Tanvir500/Radiation-Pattern-of-LED/EEE460G2_Group5_report.pdf

B A N G L A D E S H UN I V E R S I T Y O F E N G I N E E R I N G A N D TE C H N O L O G Y

DE P A R T M E N T O F EL E C T R I C A L A N D EL E C T R O N I C E N G I N E E R I N G

# EEE 460 (January 2024)

## Optoelectronics Laboratory

# Final Project Report

## Section: G2, Group: 05

# Radiation Pattern of LED

# Course Instructors:

Sadman Sakib Ahbab, Lecturer
Tanushri Medha Kundu, Part-Time Lecturer

Signature of Instructor: ___________________________________________________

# Academic Honesty Statement:

IMPORTANT! Please carefully read and sign the Academic Honesty Statement, below. Type the student ID and name, and put your signature. You will not receive credit for this project experiment unless this statement is signed in the presence of your lab instructor.

“In signing this statement, We hereby certify that the work on this project is our own and that we have not copied the work of any other students(past or present), and cited all relevant sources while completing this project. We understand that if we fail to honor this agreement, We will each receive a score of ZERO for this project and be subject to failure of this course.”

Signature: ____________________________
Full Name: Md. Ali Ahmed
Student ID: 1906143

Signature: ____________________________ Full Name: Manjur Muntasir
Student ID: 1906150

Signature: ____________________________ Full Name: Tanvir Rahman
Student ID: 1906176

Signature: ____________________________ Full Name: Samiul Hossain
Student ID: 1906179

i

# Table of Contents

________________________________________________________________________________________
Radiation Pattern of LED | EEE 460 (January 2024) G2, Group 05- Final Project
Front Matter ii

________________________________________________________________________________________

## 1 Abstract

LED radiation patterns change with angle, significantly affecting the intensity and overall performance, making accurate measurement crucial for various applications. To analyze these patterns effectively, a measurement setup in an enclosed environment is utilized, ensuring minimal external interference. The LEDs are positioned at fixed angles relative to a light intensity sensor to capture angular variations in radiation. Tools such as Arduino are employed for precise measurement and data analysis, enabling reliable and consistent results. The setup is designed to facilitate easy replacement of LEDs, allowing the testing of different colors such as red and green, making it versatile for various experiments. This streamlined and repeatable measurement process supports the optimization of lighting designs to achieve improved efficiency and enhances optical communication systems for superior performance.

## 2 Introduction

An LED is a semiconductor device that produces light when an electric current flows through it. It emits light directionally, with the highest intensity radiating perpendicularly to its surface. The majority of the emitted energy is concentrated within a 20° angle around this peak direction. Measuring the radiation pattern of LEDs is crucial for evaluating their optical properties. This pattern reveals how light is distributed in various directions, offering essential insights for optimizing LED designs in applications such as lighting, displays and optical communication systems.
Accurate measurement of an LED’s radiation pattern requires a carefully designed experimental setup. Such a setup ensures precise, consistent data collection and involves a range of well-selected components and instruments that map the spatial light distribution effectively. In this project, we detail the experimental arrangement used to measure LED radiation patterns, including components like light sources, detectors, microcontrollers and power supplies. By maintaining controlled environmental conditions and calibrating the equipment, we can generate reliable data to analyze LED performance under various operating scenarios.
This study highlights the role and significance of each component in the experimental setup, emphasizing their contributions to measurement accuracy. The project's ultimate aim is to thoroughly investigate the radiation patterns of LEDs of different types, colors and sizes across varying angles, providing a comprehensive understanding of their optical behavior.

## 3 Design

### 3.1 Problem Formulation

### 3.1.1 Identification of Scope

Application of Engineering Principles: This project applies core engineering concepts by using sensors and Arduino-based setups to measure LED radiation patterns. The process includes capturing light intensity data at various angles and analyzing it to understand LED behavior, demonstrating the integration of hardware and software in solving measurement challenges.

Problem Analysis: A key aspect of this study is understanding and quantifying how LED light intensity varies with angular positioning. By analyzing these variations, the project identifies patterns and relationships that influence LED performance.

Practical Skills Development: The project provides hands-on experience in designing, implementing, and optimizing experimental setups. Participants gain practical skills in configuring sensors, programming Arduino boards, calibrating equipment, and troubleshooting, which are valuable for real-world applications.

Contribution to Real-World Applications: Insights from LED radiation patterns can improve optical communication systems by optimizing light emission properties and aid in designing energy-efficient lighting solutions for applications ranging from residential to industrial settings.

### 3.1.2 Literature Review

Alessandro et al. (2023) explored the use of UV LEDs for curing UV protective coatings on the inner surfaces of pipes in the oil and gas industry. The optimal lamp design was determined by simulating and evaluating radiation patterns based on LED arrangement and spacing to minimize intensity variation on the pipe surface. The constructed lamp's irradiance was experimentally validated using a radiometer.

Moreno et al. (2022) measured the pattern using Gaussian or cosine-power function which is applicable for diverse LED types.

### 3.1.3 Formulation of Problem

The formulation of the problem for this project focuses on accurately measuring the radiation pattern of LEDs to optimize their application in lighting environments. The primary challenges involve ensuring precise light intensity measurement across different angles and eliminating external interference from ambient light. The goal is to develop a reliable setup that produces valuable insights for designing effective LED lighting systems.

### 3.1.4 Analysis

The goal is accurately measuring the radiation pattern of LEDs by addressing key challenges such as ensuring precise light intensity measurement across different angles and eliminating external interference from ambient light. The objective is to develop a reliable, simple and robust setup that provides valuable insights for optimizing LED lighting systems.

### 3.2 Design Method

Design Method for Measuring LED Radiation Pattern:

### 1. Setup Overview:

The experimental design focuses on precisely measuring the radiation pattern of an LED by determining the relationship between the angle and light intensity. The setup consists of a stationary LED and a rotating BH1750 light intensity sensor, controlled by a stepper motor. An Arduino Nano microcontroller coordinates the operation, while MATLAB is used for data analysis and visualization. The whole setup is put in a box that covers it from all sides ensuring no light gets into it while testing.

### 2. Hardware Components:

LED: The light-emitting diode under test is fixed in a stable position to ensure accurate measurement without displacement.
BH1750 Light Intensity Sensor: A digital light sensor with high precision, used to record the intensity of light at different angles.
Stepper Motor: Provides precise angular movement, allowing the sensor to rotate around the LED in controlled increments over a range of 180 degrees.
Arduino Nano: Acts as the central controller, managing the stepper motor's movement and collecting intensity data from the BH1750 sensor.
Power Supply: Provides necessary power to the LED, Arduino and stepper motor.

### 3. Procedure:

Step 1: Initial Setup: Mount the LED and BH1750 light sensor securely on the setup. The LED is positioned at the center, while the sensor is fixed on a rotating arm connected to the stepper motor.
Step 2: System Calibration: Calibrate the BH1750 sensor to ensure accurate intensity measurements. Verify the stepper motor’s angular movement to confirm it aligns with the desired resolution (e.g., 1.8° per step).
Step 3: Data Acquisition: The Arduino Nano initiates the stepper motor, rotating the sensor around the LED in predefined increments. At each step, the BH1750 measures the light intensity and sends the data, along with the current angle, to the Arduino.
This process continues until the sensor completes the 180-degree sweep.
Step 4: Data Transmission: After completing the measurements, the Arduino sends the collected angle-intensity data to a connected computer via serial communication.

### 4. Data Analysis and Visualization:

The data is imported into MATLAB, where it is processed and plotted.
Using MATLAB's plotting functions, the radiation pattern is visualized as a polar plot or Cartesian graph, providing a clear representation of light intensity distribution at various angles.

### 5. Advantages of the Design:

Precision: The stepper motor ensures accurate angular positioning of the sensor. Automation: The Arduino Nano automates data collection, minimizing human error. Flexibility: The setup can be adapted to test LEDs of different sizes, colors or power ratings.

### 3.3 Circuit Diagram

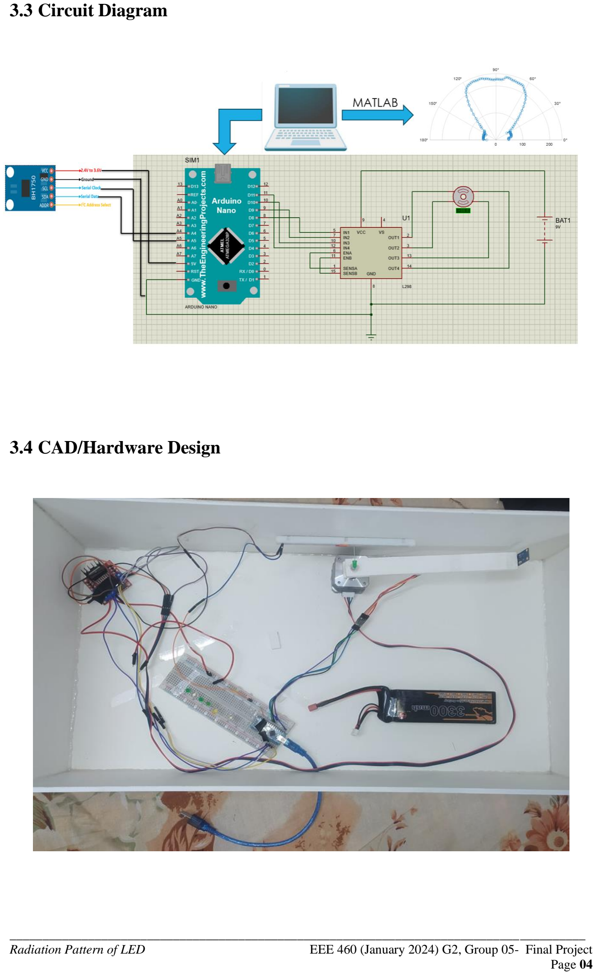
[picture p1: page 7]

### 3.4 CAD/Hardware Design

### 3.5 Full Source Code of Firmware

Arduino Code:

#include <Stepper.h> | clc;

#include <BH1750.h> | close all;

#include <Wire.h> | clear;

// Stepper Motor Settings | % MATLAB script to read serial data from Arduino and
const int stepsPerRevolution = 100; // Number of steps | plot lux vs angle
per revolution for your motor
const float stepAngle = 180.0 / stepsPerRevolution; // | % Parameters
Degrees per step | serialPort = 'COM4'; % Replace with your Arduino's
Stepper myStepper(stepsPerRevolution, 8, 9, 10, 11); // | serial port
Motor pins | baudRate = 9600;

// Light Sensor Settings
BH1750 lightMeter;
// Measurement Settings | configureTerminator(arduino, 'LF'); % Ensure the data
const int numMeasurements = 50; // Number of light | is newline-terminated
readings per step | flush(arduino); % Clear any old data in the buffer
const int stepDelayMs = 510; | // Delay after each
step (ms) | % Wait for Arduino to send "READY"
const int measureDelayMs = 10; // Delay between light | disp('Waiting for Arduino to initialize...');
readings (ms) | while true
// Variables | disp(line); % Display for debugging
float currentAngle = 0.0; | if contains(line, "READY")
void setup() { | break;
// Initialize Serial communication | end
Serial.begin(9600); | end
Serial.println("Arduino Light Measurement and Motor
Control");
// Initialize I2C and BH1750 | writeline(arduino, "RUN");
Wire.begin(); | disp('RUN command sent to Arduino.');
if (!lightMeter.begin()) {
Serial.println("Error initializing BH1750 sensor"); | % Initialize data arrays
while (1); // Halt execution if sensor | angles = [];
initialization fails | luxValues = [];
}
Serial.println("BH1750 sensor initialized");
// Initialize Stepper motor | while numel(angles) < expectedSteps
myStepper.setSpeed(5); // Set motor speed (RPM) | line = readline(arduino); % Read a line of

// Notify MATLAB that Arduino is ready
Serial.println("READY");
// Wait for "RUN" command from MATLAB | if contains(line, "Step") || contains(line,
while (true) { | "Measurement complete")
if (Serial.available()) { | continue;
String command = Serial.readStringUntil('\n'); | end
command.trim();
if (command == "RUN") { | % Parse the CSV data (Step, Angle, Lux)
Serial.println("RUN RECEIVED"); | data = split(line, ',');
break; // Exit loop and proceed | if numel(data) == 3
} | angle = str2double(data{2}); % Convert
} | angle to numeric
delay(100); // Avoid busy-waiting | lux = str2double(data{3}); % Convert lux
} | to numeric
}
void loop() { | degrees
for (int stepCount = 0; stepCount < | if angle <= 180
stepsPerRevolution; ++stepCount) { | angles(end+1) = angle; %#ok<SAGROW>
// Move one step | luxValues(end+1) = lux; %#ok<SAGROW>
myStepper.step(-1); | end
currentAngle += stepAngle; | end

delay(stepDelayMs); // Wait for motor to stabilize

// Take multiple light readings and calculate | interruption)
average | disp('Stopped reading data from Arduino.');
float lightSum = 0.0; | end
for (int i = 0; i < numMeasurements; ++i) {
lightSum += lightMeter.readLightLevel(); | % Close the serial port
delay(measureDelayMs); | clear arduino;
}

Matlab Code:

expectedSteps = 100; % Total number of steps expected

% Open the serial port
arduino = serialport(serialPort, baudRate);

line = readline(arduino);

disp('Arduino is ready.');

% Send the "RUN" command to start the motor and measurements

% Read data from serial port try

data
disp(line); % Display the line for debugging

% Skip lines that don't contain valid data

% Append to arrays if angle is within 0–180

end
catch
% Stop reading when an error occurs (e.g., user

Table: Source Code for the main program

## 4 Implementation

### 4.1 Description

### Implementation of LED Radiation Pattern Measurement Design

### 1. Hardware Assembly

a. Components Required:
- LED: Secure the LED on a stable base to ensure it remains fixed during the experiment.
- BH1750 Light Sensor: Mount this sensor on a rotating arm attached to the stepper motor.
- Stepper Motor: Use a bipolar stepper motor for precise angular movement of sensor.
- Arduino Nano: Act as the controller for the system.
- Motor Driver Module: Such as ULN2003 (for unipolar motors) or A4988 (for bipolar motors), to interface the stepper motor with the Arduino.
- Power Supply: Provide stable power for the motor, Arduino, and LED.
- Connecting Wires: For wiring components to the Arduino.
- Breadboard or PCB: For organizing connections.
b. Assembly Steps:
1. Fix the LED in the center of a circular base.
2. Attach the BH1750 sensor to an arm extending from the stepper motor's shaft. Ensure the arm is long enough to position the sensor at a suitable distance from the LED.
3. Connect the stepper motor to the Arduino Nano via the motor driver module.
4. Wire the BH1750 sensor to the Arduino Nano using I2C communication (SCL and SDA pins).
5. Connect the power supply to all components.

### 2. Arduino Programming (Code above)

float lightAverage = lightSum / numMeasurements;

// Send data to Serial
Serial.print(stepCount + 1); // Step number | % Plot the data in a radial plot
Serial.print(", "); | figure;
Serial.print(currentAngle, 2); // Angle in degrees | polarplot(anglesRad, luxValues, '-o');
Serial.print(", "); | title('Light Intensity vs Angle (0–180 degrees)');
Serial.println(lightAverage, 2); // Average light | ax = gca;
in lx | ax.ThetaLim = [0 180]; % Limit the angle to 0–180
} | degrees
// Return to the initial position | ax.RGrid = 'on';
myStepper.step(stepsPerRevolution); | ax.ThetaTick = 0:30:180; % Set angular ticks
Serial.println("Measurement complete.");
while (true) {
delay(1000); // Halt execution
}
}

% Convert angles to radians for polar plotting anglesRad = deg2rad(angles);

ax.RLim = [0 max(luxValues)+10];

### 3. Data Collection

1. Upload the code to the Arduino Nano.
2. Open the Arduino IDE Serial Monitor to view angle vs. light intensity data in real-time.
3. Copy the data into a text file or spreadsheet for further processing.

### 4. Data Analysis in MATLAB

Testing and Calibration:

- Test the setup by rotating the sensor manually to confirm alignment with the LED.
- Calibrate the BH1750 sensor in standard lighting conditions to ensure right measurements.

Expected Output:

- A polar plot in MATLAB showing the distribution of light intensity as a function of angle.
- Additional data insights can be extracted by analyzing intensity variations across the angular sweep.

### Challenges to Implementation:

1) Increasing cost if we use multiple sensor.
2) Ensuring no light from environment.
3) Stepper motor coil issues.
4) Motor driver excessive heating problem due to high current draw.
5) Get real time data analysis.
6) Defects in jumper wires.
7) Sending data to MATLAB while plotting.

## 5 Design Analysis and Evaluation

### 5.1 Novelty

Automation of Measurement:

This project introduces an automated approach to measuring LED radiation patterns, utilizing an Arduino microcontroller to streamline the process. Traditionally, such measurements have been conducted manually in the BUET Optoelectronic Lab, a method that is both time-consuming and prone to human error. By automating the system, we significantly enhance time efficiency and ensure consistent and accurate data collection. The automated setup involves precise motorized control of sensor movements, synchronized with real-time data acquisition. This eliminates the need for manual adjustments and readings, allowing for faster measurements and more reliable results. Moreover, the integration of automation reduces variability in experimental conditions, thereby improving the repeatability of measurements and the overall quality of the data.

Customized Radiation Pattern Analysis:

The developed system is not only efficient but also versatile, enabling detailed analysis of LED radiation patterns tailored to diverse applications. By leveraging the precision and flexibility of the automated setup, the system can characterize LEDs for specific use cases such as agriculture, lighting design and automotive applications. For instance:

Agriculture: Understanding the radiation pattern of LEDs used in grow lights helps optimize light distribution, ensuring plants receive uniform illumination for better growth.

Lighting Design: Analyzing radiation patterns aids in designing energy-efficient and aesthetically pleasing lighting systems for residential, commercial or industrial use.

Automotive: Detailed radiation pattern measurements help in designing headlights and interior lights that enhance visibility and safety.

This tailored approach allows for the selection and modification of LEDs to meet specific requirements, ensuring that lighting solutions are efficient, cost-effective and optimized for their intended purpose. Through automation and customization, the project not only advances experimental methodology but also contributes to practical, real-world lighting innovations.

### 5.2 Design Considerations

### 5.2.1 Considerations to public health and safety

This project focuses on considerations for public health and safety related to LED radiation patterns and measurement setups. The study emphasizes the need for a controlled environment to minimize external interference and ensure accurate intensity measurements. It addresses potential risks by carefully positioning LEDs and utilizing tools like Arduino for precise data collection. The project aims to optimize lighting designs and enhance optical communication systems, all while ensuring the safety and well-being of individuals through rigorous adherence to safe measurement practices.

### 5.2.2 Considerations to environment

The project considers environmental impacts related to LED radiation patterns and measurement setups. It involves minimizing external interference by using an enclosed environment, which reduces the potential for interference from the surroundings. The design also takes into account the energy efficiency of lighting systems and optical communication technologies, aiming to reduce their environmental footprint. By employing tools like Arduino for precise measurements, the project promotes sustainable practices, ensuring that the setup and outcomes are environmentally friendly and contribute positively to the surrounding ecosystem.

### 5.2.3 Considerations to cultural and societal needs

The project considers cultural and societal needs by addressing the impact of LED radiation patterns on lighting designs and optical communication systems. It ensures that the measurement setup is adaptable to different societal preferences for light quality and color. The project also takes into account cultural considerations such as lighting aesthetics and energy consumption, aiming to align technological advancements with societal values. By providing a streamlined and flexible measurement process, the project supports the development of lighting solutions that meet diverse cultural requirements, enhancing user experience and contributing positively to societal needs.

### 5.3 Investigations

### 5.3.1 Results and Analysis

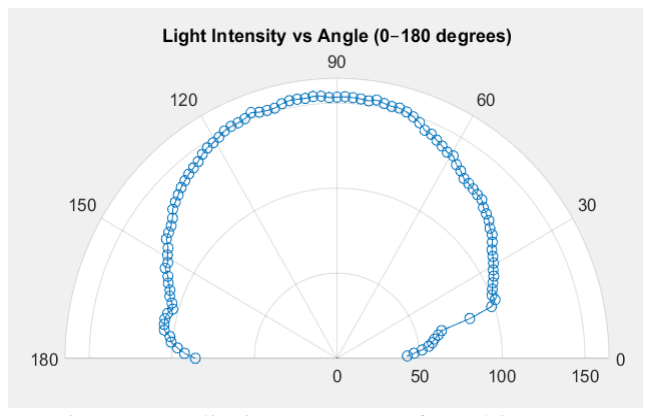
[picture p2: figure]

Figure: Radiation pattern of a white LED

This particular LED had a hemispherical enclosure and consequently, the shape of the radiation pattern matches the shape for a hemispherical LED in literature.

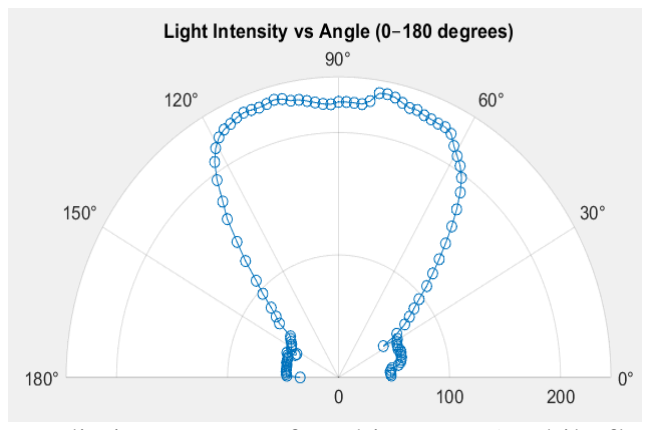
[picture p3: figure]

Figure: Radiation pattern of a white LED (mobile flashlight)

A phone’s flashlight needs to cover a greater angle than typical directional LEDs. This can be seen from its radiation pattern.

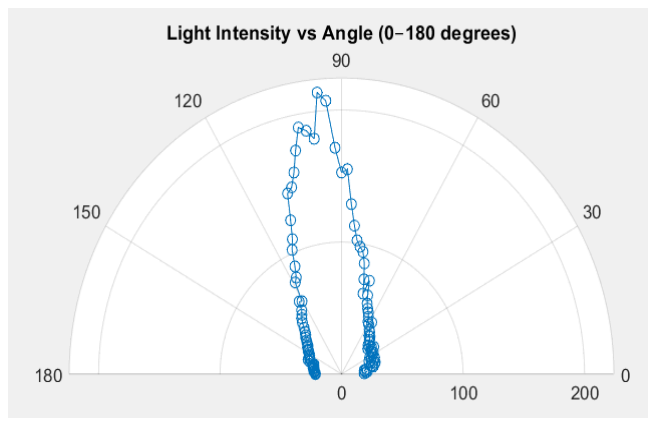
[picture p4: figure]

Figure: Radiation pattern of a green LED.

The casing of this particular LED was parabolic. Hence, we see this highly directional pattern. Our ideal sensor distance was measured for this particular LED and was then fixed.

### 5.3.2 Interpretation and Conclusions on Data

It is clear that our setup can measure radiation patterns of LEDs of differing colors and casing shapes. For the measurements that we carried out, the reflections of light within our box do not interfere with the data to the extent that the radiation pattern shape is inaccurate for various shapes. Moreover, the setup of our sensor to led distance seems optimum. For the mechanical jittering of the motor, we think our averaging scheme works well to smooth out any deviations in the measurements due to sudden movements of the arm.

### 5.4 Limitations of Tools

The proposed system for measuring LED radiation patterns, while innovative and effective, has limitations in the tools and components used. The BH1750 light sensor, though convenient, has a broad field of view, reducing precision for narrow beam patterns and limiting multi-spectral analysis due to its inability to differentiate wavelengths. Additionally, it may saturate under high-intensity LEDs without the use of optical filters. The stepper motor, responsible for sensor rotation, has constraints such as limited angular resolution, potential vibration, and a trade-off between speed and precision. Arduino Nano, as the controller, introduces limitations with its low processing power, limited memory and insufficient I/O pins for more complex setups. It also lacks onboard storage and wireless communication capabilities, which could hinder real-time data transfer. Serial communication for data transfer to MATLAB is another bottleneck, as it slows down the process and depends heavily on external software for analysis. Environmental factors like ambient light interference and temperature variations can further impact the accuracy of measurements if not carefully controlled. Additionally, mechanical challenges such as sensor arm stability and space requirements for free rotation may pose practical difficulties. To mitigate these challenges, advanced sensors for multi-spectral measurements, high-resolution or servo motors for improved precision, more powerful microcontrollers like ESP32 and optimized setups in controlled environments can be considered. Real-time processing and wireless data transfer could also enhance efficiency and flexibility, making the system more robust and suitable for a broader range of applications.

### 5.5 Impact Assessment

### 5.5.1 Assessment of Societal and Cultural Issues

This project on measuring the radiation pattern of LEDs holds societal and cultural significance, as it contributes to the optimization of LED-based lighting systems, which are widely used in homes, workplaces and public spaces. Proper understanding and measurement of LED radiation patterns enable the design of lighting that is energy-efficient, safe and adaptable to diverse cultural needs.

For example, in regions where bright lighting is a cultural preference, accurately designed LED systems can enhance illumination without causing discomfort or glare. Additionally, by ensuring consistent light distribution, the project supports applications like street lighting, which improves public safety and accessibility in communities.

### 5.5.2 Assessment of Health and Safety Issues

This project addresses critical health and safety concerns associated with LED usage by providing insights into their radiation patterns. LEDs, while energy-efficient, can pose potential risks such as glare and blue light exposure, which are known to cause eye strain, discomfort or long-term damage under certain conditions.

By accurately measuring the radiation pattern, the project helps identify and mitigate such risks. For example, optimizing beam direction and intensity can reduce glare in applications like office lighting or automotive headlights, thereby enhancing visual comfort and safety.

The project setup itself also prioritizes safety, such as ensuring stable mounting of components, proper wiring to avoid electrical hazards and shielding the experimental area from external light to maintain accurate and safe measurements. These considerations align with public health standards and emphasize the importance of safe, user-friendly lighting technologies.

### 5.5.3 Assessment of Legal Issues

The project touches on legal considerations relevant to the design and implementation of LED lighting systems, particularly compliance with standards and regulations governing light emissions. Regulatory bodies often impose limits on aspects like blue light intensity, flicker rates and glare to ensure public safety and well-being.

Accurately measuring the radiation pattern of LEDs helps ensure that the designs comply with these legal requirements. For instance, adhering to standards like those set by the International Commission on Illumination (CIE) or regional guidelines for environmental light pollution can prevent potential legal challenges.

Additionally, the experimental setup must comply with electrical safety regulations, particularly in handling power supplies and electronic components, to avoid accidents and liability during research and development phases. This proactive assessment minimizes risks of non-compliance and ensures the project aligns with industry standards.

### 5.6 Sustainability Evaluation

The project evaluates sustainability by considering the environmental and energy efficiency impacts of LED radiation patterns and measurement setups. It involves using a controlled environment to minimize energy consumption and reduce waste, while tools like Arduino allow for precise measurements that optimize resource use. The design aims to enhance the sustainability of lighting systems and optical communication technologies by ensuring they are energy-efficient and environmentally friendly. By evaluating these factors, the project supports long-term sustainability goals, aligning with broader efforts to minimize the environmental impact and promote sustainable practices within technological developments.

### 5.7 Ethical Issues

The project addresses ethical issues by carefully considering the implications of LED radiation patterns and measurement setups on public health, safety and the environment. It prioritizes safe and controlled environments to mitigate potential risks to individuals from LED emissions, ensuring that measurement practices do not harm public health. Ethical considerations also include the responsible use of technology to minimize environmental impact and promote energy efficiency. The project aims to align its outcomes with ethical standards by prioritizing user safety, environmental stewardship and sustainable practices, ensuring that technological advancements contribute positively to society without compromising ethical values.

## 6 Reflection on Individual and Team work

### 6.1 Individual Contribution of Each Member

Ali Ahmed (1906143) and Tanvir Rahman (1906176) procured the electronics, motor, batteries and wires for the project. The Hardware setup was built by mainly Ali Ahmed with the help of Samiul Hossain (1906179). The code and interfacing part was done mainly by Manjur Muntasir (1906150), Tanvir Rahman and also Samiul Hossain. The entire software setup was done using the laptops of Tanvir Rahman and Samiul Hossain.

### 6.2 Mode of TeamWork

Most of the work was done in the Hall Library of Titumir Hall, BUET. Some current and voltage measurements were required for debugging purposes. We carried those out in the Electronics Lab, ECE building, BUET.

## 7 Communication to External Stakeholders

### 7.1 Executive Summary

An exciting LED radiation measurement system is here! Designed to automate traditionally manual processes, this innovative setup uses an Arduino microcontroller, a rotating light sensor, and stepper motors to capture precise data on how LEDs emit light. This data helps optimize LEDs for real-world applications like agriculture, automotive lighting, and smart homes. By combining automation and advanced data processing, the system ensures faster, more accurate results than ever before. This project not only simplifies the task but also lays the foundation for smarter, energy-efficient lighting solutions to brighten our future.

### 7.2 User Manual

Operating the setup is really easy and simple. First, we need to place the LED that we want to measure inside the box in the LED holder just above the motor. Then we need to close the lid of the box after giving power to the sensor and motor. Then we have to start the Matlab code and it will start the process, get values from serial monitor and give us the desired polar plot automatically. The whole process is done in under two minutes.

## 8 Project Management and Cost Analysis

### 8.1 Bill of Materials

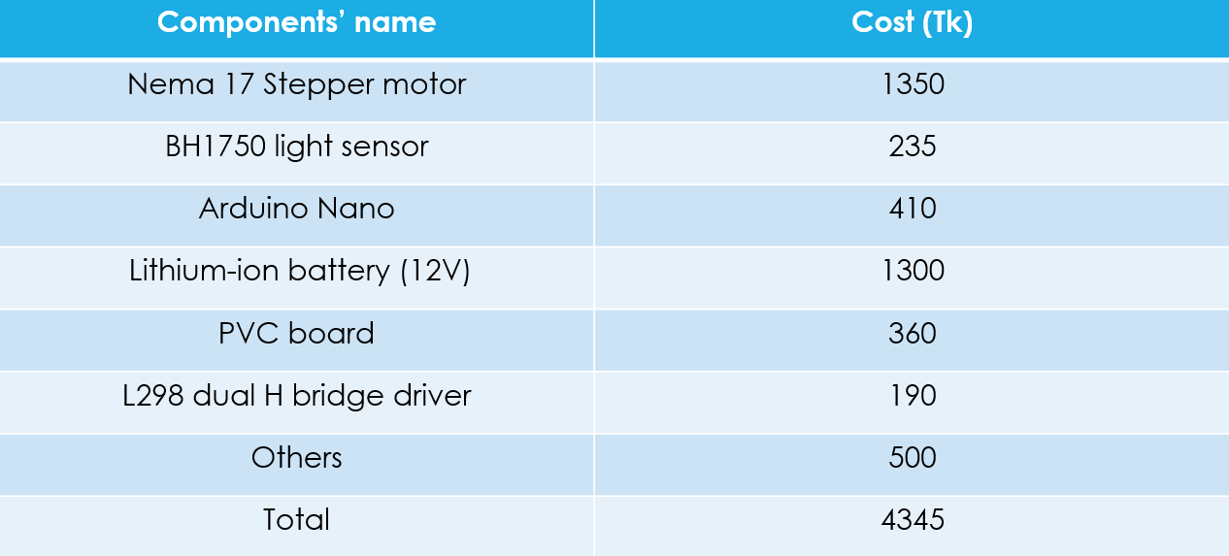
[picture p5: figure]

## 9 Future Work

### Future Directions and Enhancements:

### 1. Integration of Advanced Multi-Spectral Sensors

Incorporating advanced multi-spectral sensors into the measurement system will enable more precise and comprehensive analysis of LED radiation patterns. These sensors can measure light intensity across different wavelengths, providing detailed spectral information. This capability is particularly beneficial for applications such as horticulture, where specific wavelength ranges significantly influence plant growth, or for medical devices requiring precise spectral control.

### 2. Development of 3D Measurement Systems

Expanding the setup to include 3D measurement capabilities will allow for a more detailed analysis of radiation patterns. By capturing light intensity data in all directions, including vertical and horizontal planes, the system can generate comprehensive 3D radiation maps. This enhancement is especially useful for applications such as automotive lighting and stage design, where spatial light distribution plays a critical role.

### 3. Real-Time Data Processing and Feedback

Integrating real-time data processing capabilities will enable instantaneous analysis of radiation patterns. This feature will allow users to make immediate adjustments to LED configurations during testing. For example, engineers can modify parameters like power input or placement angle in response to the observed radiation pattern, streamlining the optimization process and reducing development time.

### 4. Integration with Smart Lighting Systems

Linking the measurement system with smart lighting technologies will enable dynamic adjustments to LED radiation patterns based on environmental conditions. For instance, in smart homes or offices, the system could adapt light intensity and direction based on natural light availability, user preferences, or specific tasks. This integration supports energy efficiency and enhances user comfort.

### 5. Expansion to Support a Wider Variety of LED Types

Enhancing the system's versatility to accommodate different types of LEDs, including high-power LEDs, RGB LEDs, and specialized types for unique applications, will broaden its utility across industries. This adaptability will support research and development in fields like automotive, healthcare, entertainment, and urban planning, ensuring the system remains relevant for diverse and evolving needs.

By implementing these advancements, the system will become a powerful tool for LED characterization, offering detailed insights and supporting innovation across multiple disciplines.

## 10 References

1) https://doi.org/10.1016/j.optmat.2023.114275
2) https://www.sciencedirect.com/science/article/pii/S0925346723008479
3) https://doi.org/10.1364/OE.16.001808
